gk977246/m18-protocol/micropython/cyd2usb/library_info.txt

https://github.com/de-dh/ESP32-Cheap-Yellow-Display-Micropython-LVGL
