gk977246/m18-protocol/micropython/docs/schema.png

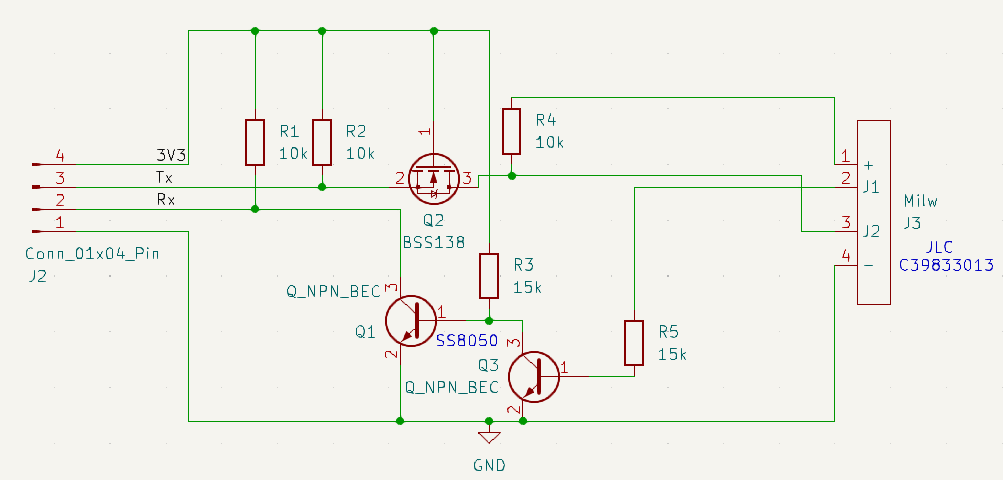
micropython/docs/schema.png
