gk977246/m18-protocol/micropython/m18Displ/m18.kicad_pcb

## KiCad design micropython/m18Displ/m18.kicad_pcb (2026-04-27)

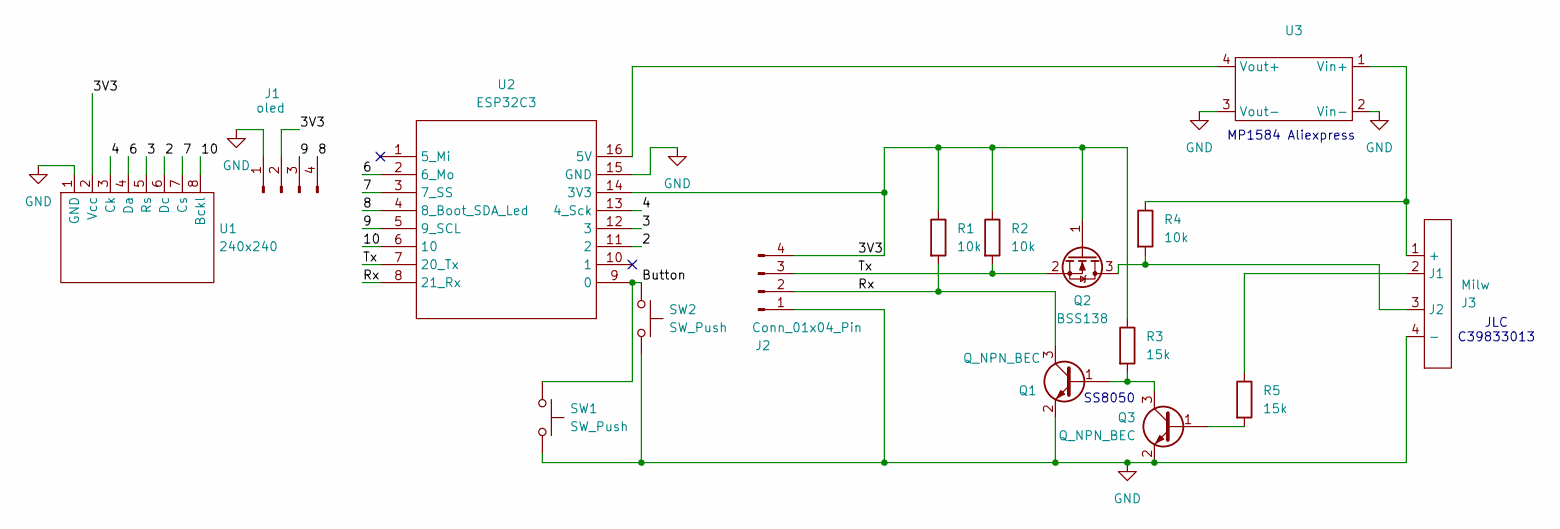
[picture p5: schematic m18.kicad_sch]

Parts:
J1: oled; 128x64Oled4Pin
J2: Conn_01x04_Pin; PinSocket_1x04_P2.54mm_Vertical
J3: Milw; Milw_Spade
Q1, Q3: Q_NPN_BEC; SOT-23
Q2: BSS138; SOT-23
R1, R2, R4: 10k; R_0603_1608Metric
R3, R5: 15k; R_0603_1608Metric
SW1: SW_Push; Sw_edge
SW2: SW_Push; SW_Push_1P1T_NO_6x6mm_H9.5mm
U1: 240x240; 170x320_7789
U2: ESP32C3; Esp32_C3_mini_module
U3: mp1584

Connections:
/2: U1.6 (Dc), U2.11 (2)
/3: U1.5 (Rs), U2.12 (3)
/3V3: J1.2, J2.4, Q2.1 (G), R1.1, R2.1, R3.1, U1.2 (Vcc), U2.14 (3V3)
/4: U1.3 (Ck), U2.13 (4_Sck)
/6: U1.4 (Da), U2.2 (6_Mo)
/7: U1.7 (Cs), U2.3 (7_SS)
/8: J1.4, U2.4 (8_Boot_SDA_Led)
/9: J1.3, U2.5 (9_SCL)
/10: U1.8 (Bckl), U2.6 (10)
/Button: SW1.1, SW2.1, U2.9 (0)
/Rx: J2.2, Q1.3 (C), R1.2, U2.8 (21_Rx)
/Tx: J2.3, Q2.2 (S), R2.2, U2.7 (20_Tx)
GND: J1.1, J2.1, J3.4 (-), Q1.2 (E), Q3.2 (E), SW1.2, SW2.2, U1.1 (GND), U2.15 (GND), U3.2 (Vin-), U3.3 (Vout-)
unnamed: J3.1 (+), R4.1, U3.1 (Vin+)
unnamed: J3.2 (J1), R5.1
unnamed: J3.3 (J2), Q2.3 (D), R4.2
unnamed: Q1.1 (B), Q3.3 (C), R3.2
unnamed: Q3.1 (B), R5.2
unnamed: U2.16 (5V), U3.4 (Vout+)

Notes on the sheet:
SS8050
MP1584 Aliexpress
JLC C39833013

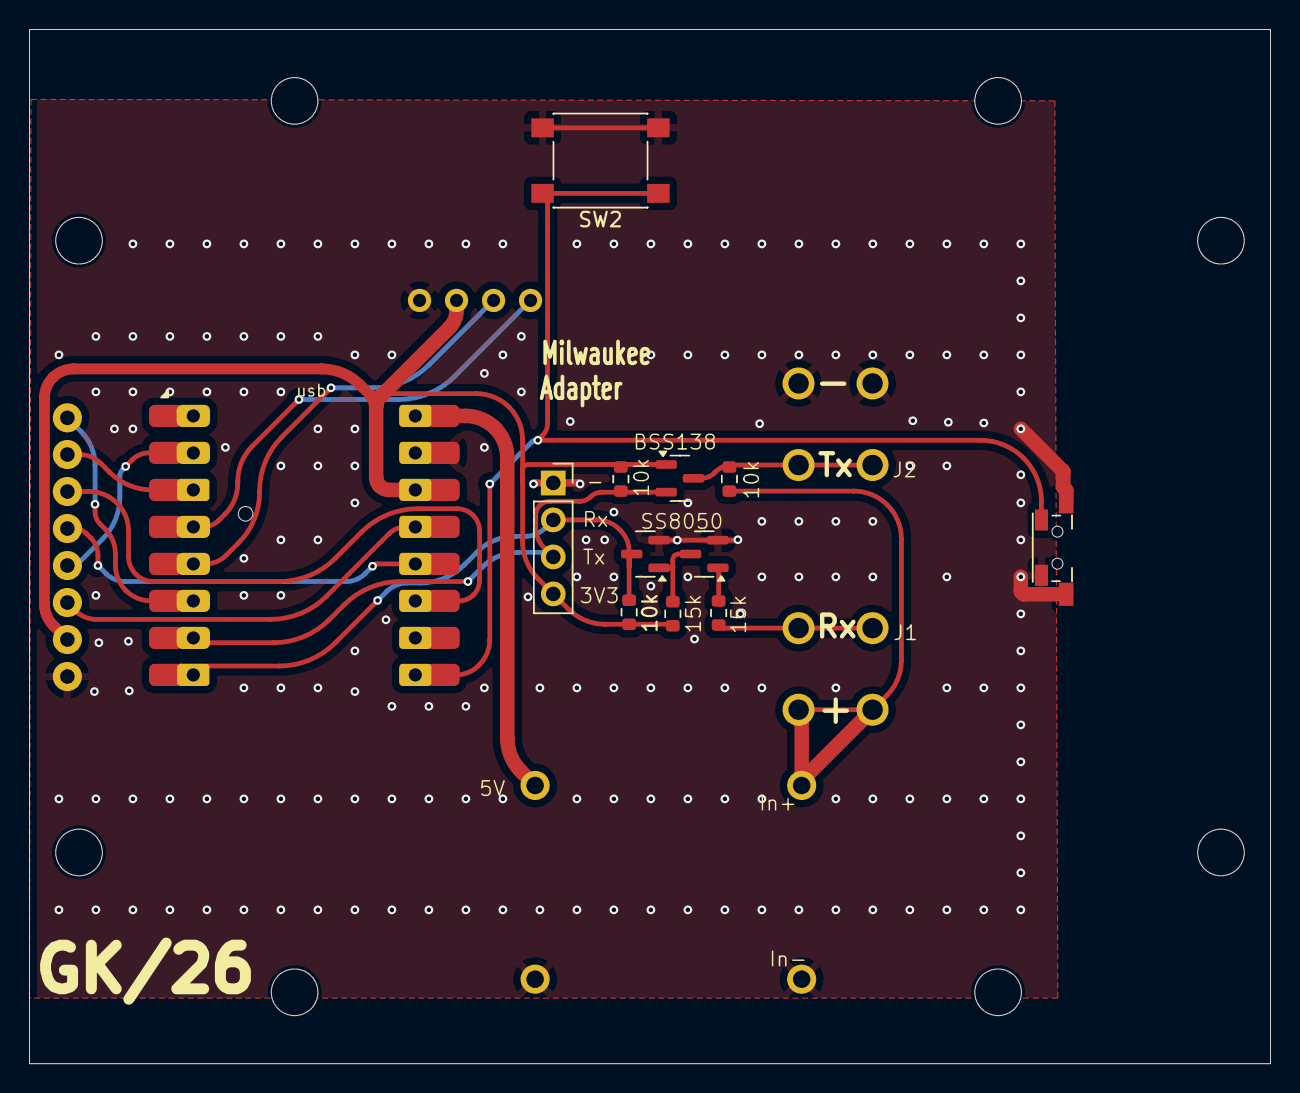
[picture p6: board m18.kicad_pcb from above]

Board: 2 copper layers, 85.2 x 71.0 mm, 16 parts (0 on the bottom side), 19 nets.
