gk977246/m18-protocol/micropython/7789/boot.py

# This file is executed on every boot (including wake-boot from deepsleep)
#import esp
#esp.osdebug(None)
#import webrepl
#webrepl.start()
from machine import Pin
line = Pin(20, Pin.OUT)
line.value(0)
