gk977246/m18-protocol/(commit log)

2026-04-25 micropython folder
    [m18-B_Cu.gbr, m18-B_Mask.gbr, m18-B_Silkscreen.gbr, m18-Edge_Cuts.gbr, m18-F_Cu.gbr, m18-F_Mask.gbr, m18-F_Silkscreen.gbr, m18-NPTH.drl]
2026-04-27 boot pins
    [m18-B_Cu.gbr, m18-B_Mask.gbr, m18-B_Silkscreen.gbr, m18-Edge_Cuts.gbr, m18-F_Cu.gbr, m18-F_Mask.gbr, m18-F_Silkscreen.gbr, m18-NPTH.drl]
